eduardocasino/k-1013-floppy-disk-controller-replica/README.md

# K-1013 Floppy Disk Controller replica

## Introduction

Welcome to my K-1013 Rev. D Floppy Disk Controller replica repository.

This aims to be a faithful replica of the K-1013 Floppy Disk Controller, an extension board for the KIM-1 designed by MTU in the late 70's/early 80's for interfacing with [Shugart Associates](https://en.wikipedia.org/wiki/Shugart_Associates) compatible 8'' and 5.25'' FDDs.

### Status

Schematic is completed and checked against the real board.

Routing is completed, still in revision.

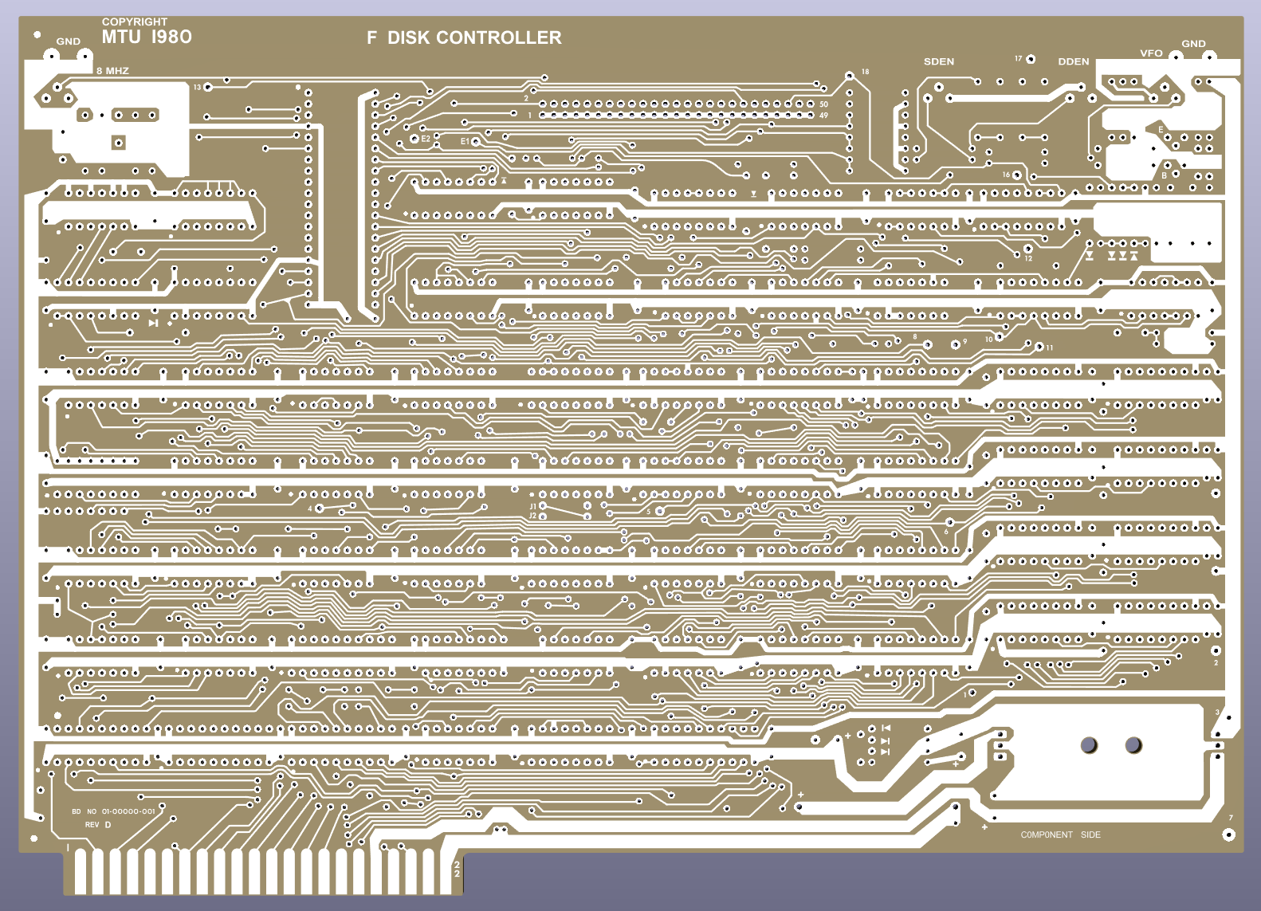
[picture p1: images/k-1013-floppy-controller-replica-front.png]
front

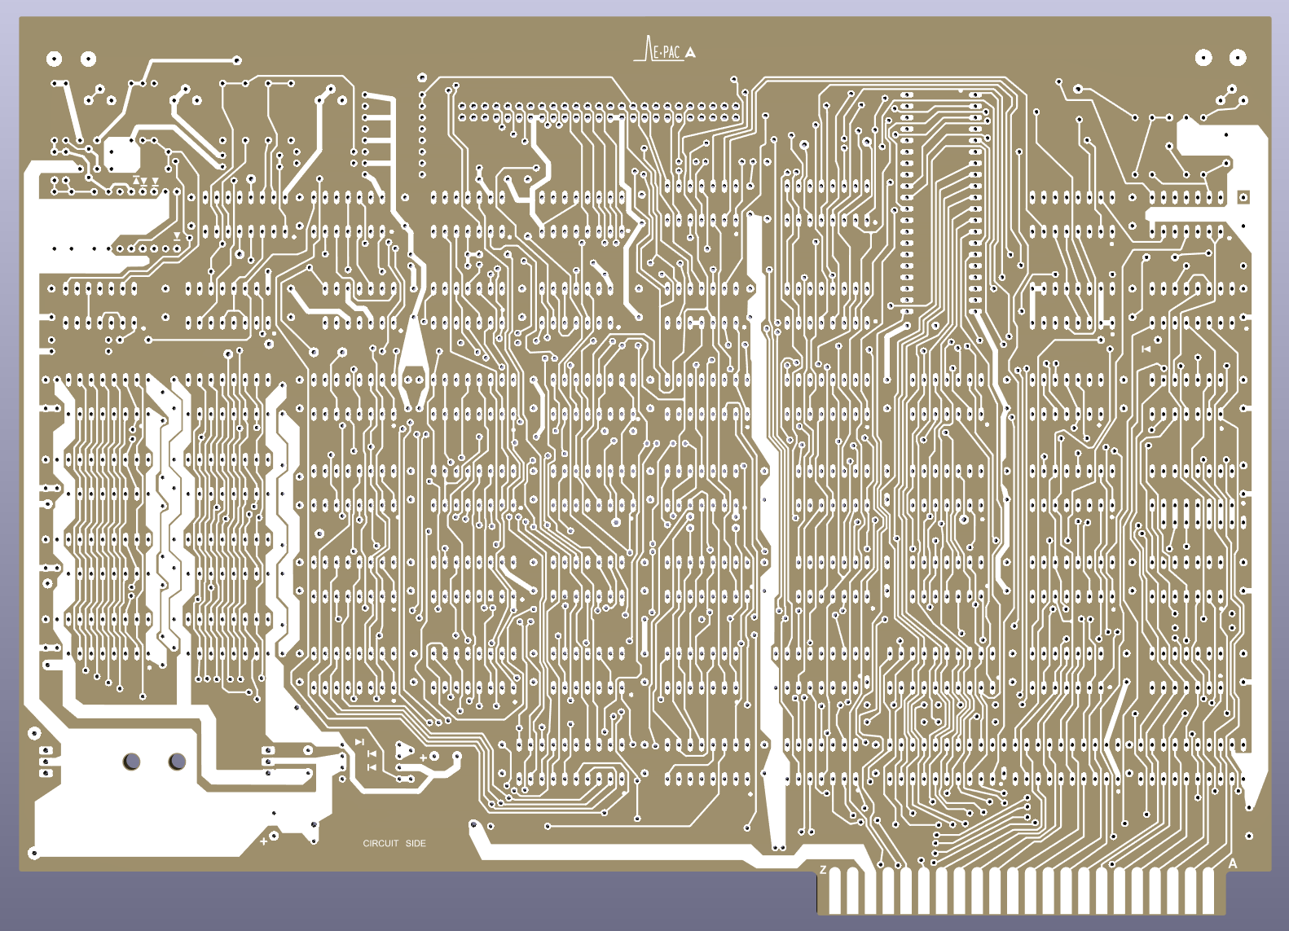
[picture p2: images/k-1013-floppy-controller-replica-back.png]
back

completed

**WARNING: This design is a work-in-progress has not been tested yet. Use at your own risk!**

## Building

TODO

## Licensing

This is a personal project that I am sharing in case it is of interest to any retrocomputing enthusiast and all the information in this repository is provided "as is", without warranty of any kind. I am not liable for any damages that may occur, whether it be to individuals, objects, KIM-1 computers, kittens or any other pets. **It should also be noted that everything in this repository is a work in progress and may contain errors. Therefore, anyone who chooses to use it does so at their own risk**.



This work is licensed under a [Creative Commons Attribution-NonCommercial 4.0 International License](http://creativecommons.org/licenses/by-nc/4.0/).

See the LICENSE.md file for details.

## Acknowledgements

* Dave Plummer, of [Dave's Garage](https://www.youtube.com/@DavesGarage) fame, for documentation and pictures of his card. I'm building this replica out of pure envy of his system!
* [David Williams](https://www.trailingedge.com/) for taking the time to disassemble his MTU-130 and send me hi-res pictures of his board.
* [Hans Otten](http://retro.hansotten.nl). Tons of documentation on his retro computing site.
