eduardocasino/k-1013-floppy-disk-controller-replica/3dmodels/3386P.STEP

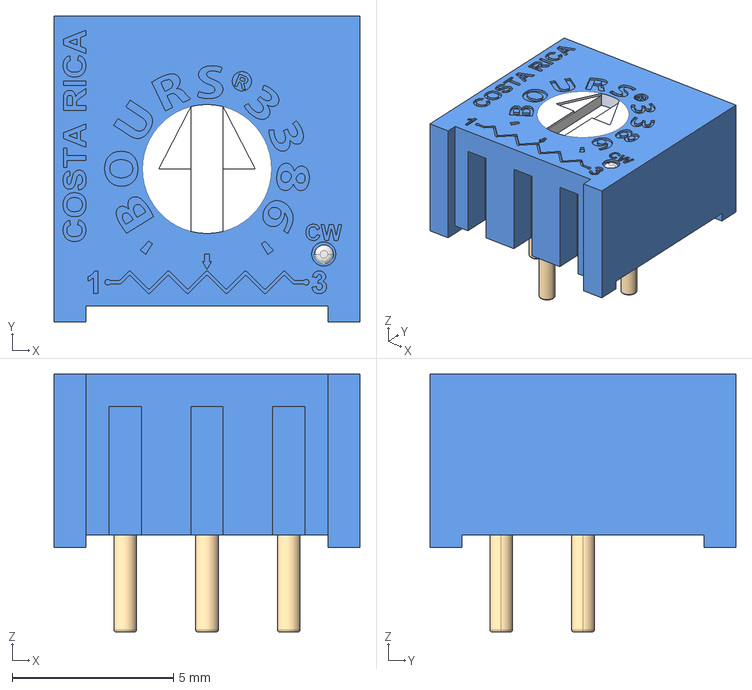
[picture p3: CAD file, 2024-11-11]
3dmodels/3386P.STEP
9.50 x 9.50 x 8.00 mm
