eduardocasino/k-1013-floppy-disk-controller-replica/3dmodels/a_16-lc-tt.stp

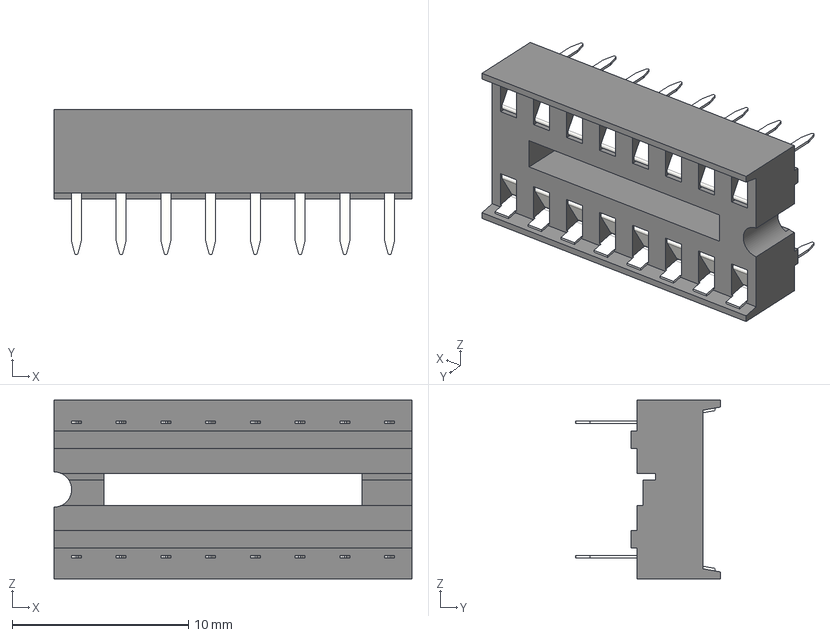
[picture p4: CAD file, 2024-11-11]
3dmodels/a_16-lc-tt.stp
20.3 x 8.25 x 10.2 mm
