eduardocasino/k-1013-floppy-disk-controller-replica/3dmodels/resistor_array_8.step

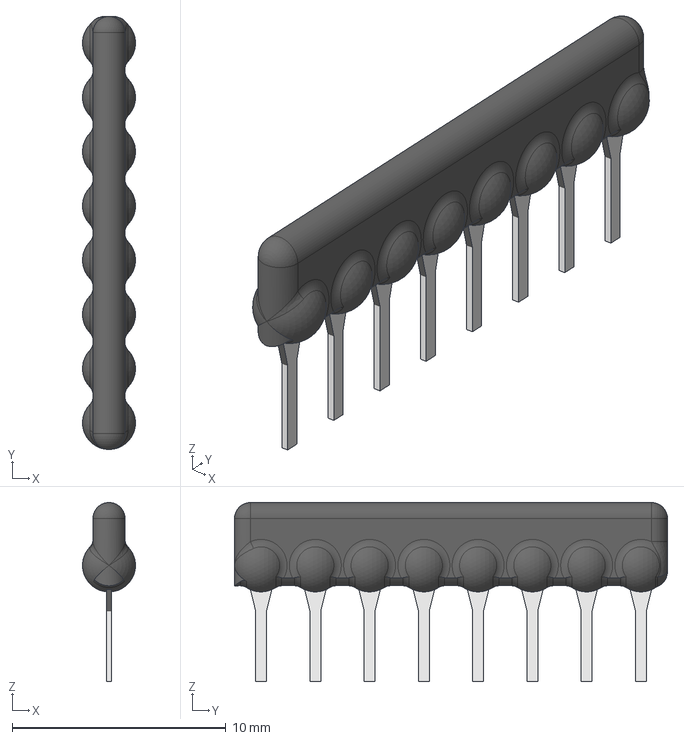
[picture p6: CAD file, 2024-09-01]
3dmodels/resistor_array_8.step
2.48 x 20.3 x 8.38 mm
