eduardocasino/k-1013-floppy-disk-controller-replica/3dmodels/DIP-20 W7.62mm IC with Socket.stp

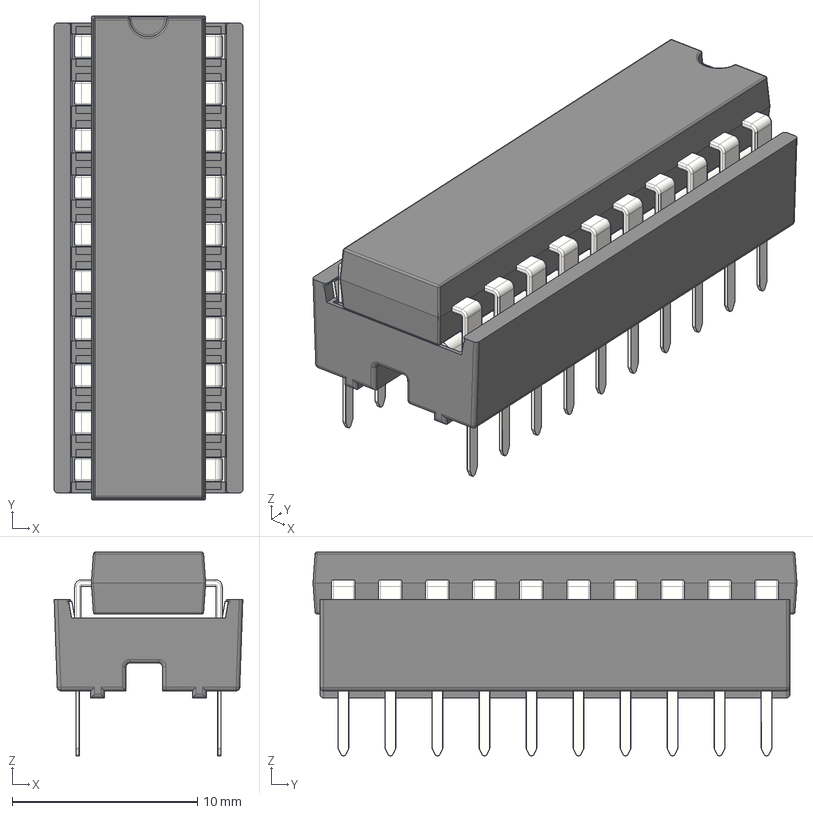
[picture p7: CAD file, 2024-09-01]
3dmodels/DIP-20 W7.62mm IC with Socket.stp
10.2 x 26.1 x 11.0 mm
Stamped Dual Wipe Contact for DIP Sockets x 20
Body DIP-20 P7.62mm Socket
IC Beinchen x 20
DIP-20 W7.62
