eduardocasino/k-1013-floppy-disk-controller-replica/3dmodels/res-1_4w-330R-12_7mm.step

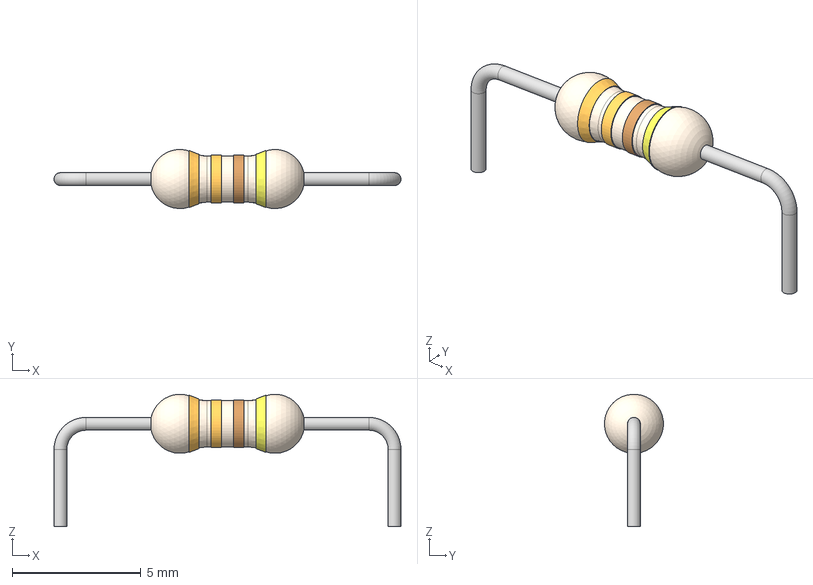
[picture p8: CAD file, 2024-09-01]
3dmodels/res-1_4w-330R-12_7mm.step
13.5 x 2.29 x 5.14 mm
Resistor-body
Ring-1
Ring-2
Ring-3
Ring-4
pins
