eduardocasino/k-1013-floppy-disk-controller-replica/3dmodels/DIP-14 W7.62mm IC with Socket.stp

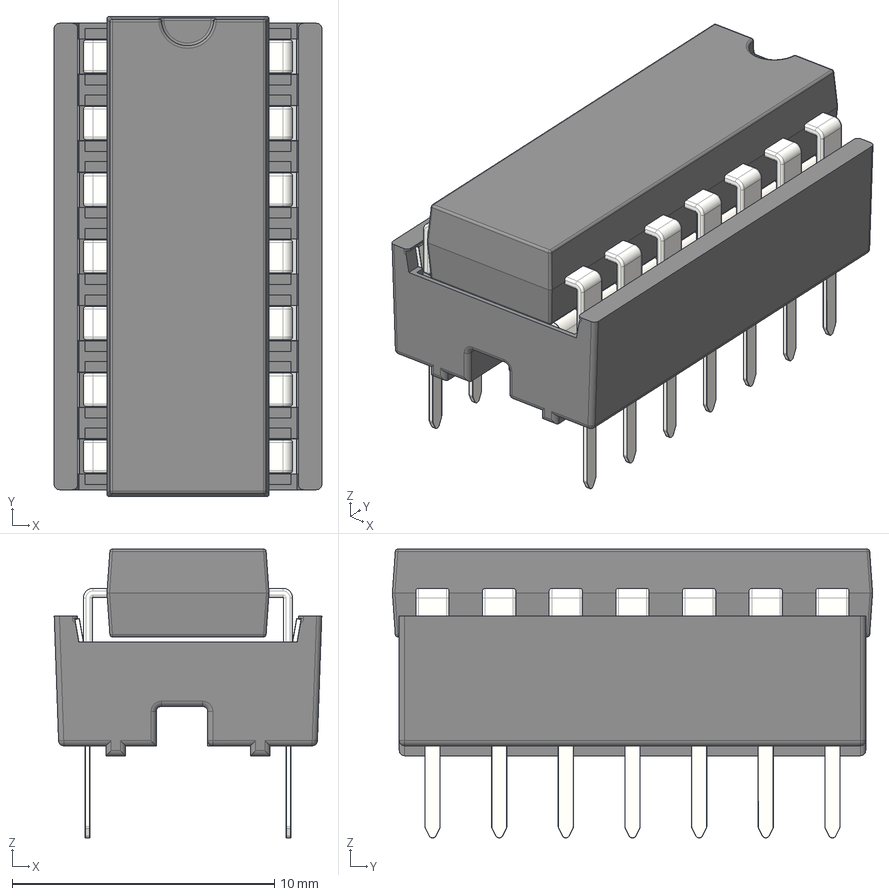
[picture p9: CAD file, 2024-09-01]
3dmodels/DIP-14 W7.62mm IC with Socket.stp
10.2 x 18.3 x 11.0 mm
Stamped Dual Wipe Contact for DIP Sockets x 14
Body DIP-14 P7.62mm Socket
IC Beinchen x 14
DIP-14 W7.62
