eduardocasino/k-1013-floppy-disk-controller-replica/3dmodels/DIP-16 W7.62mm IC with Socket.stp

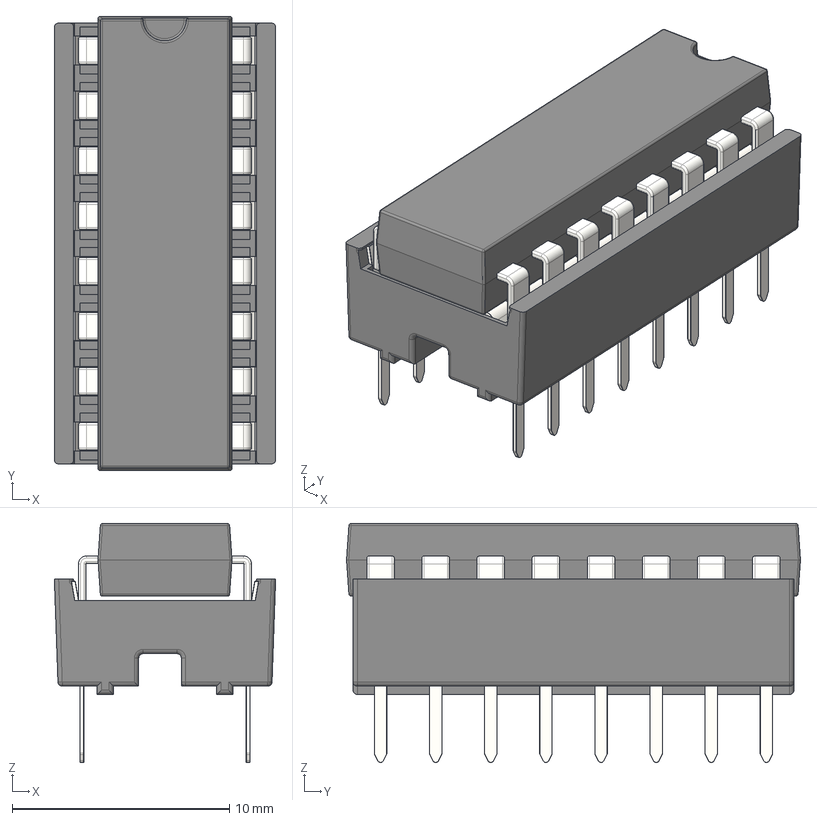
[picture p10: CAD file, 2024-09-01]
3dmodels/DIP-16 W7.62mm IC with Socket.stp
10.2 x 20.9 x 11.0 mm
Stamped Dual Wipe Contact for DIP Sockets x 16
Body DIP-16 P7.62mm Socket
IC Beinchen x 16
DIP-16 W7.62
