eduardocasino/k-1013-floppy-disk-controller-replica/3dmodels/DIP-40 W15.24mm IC with Socket.stp

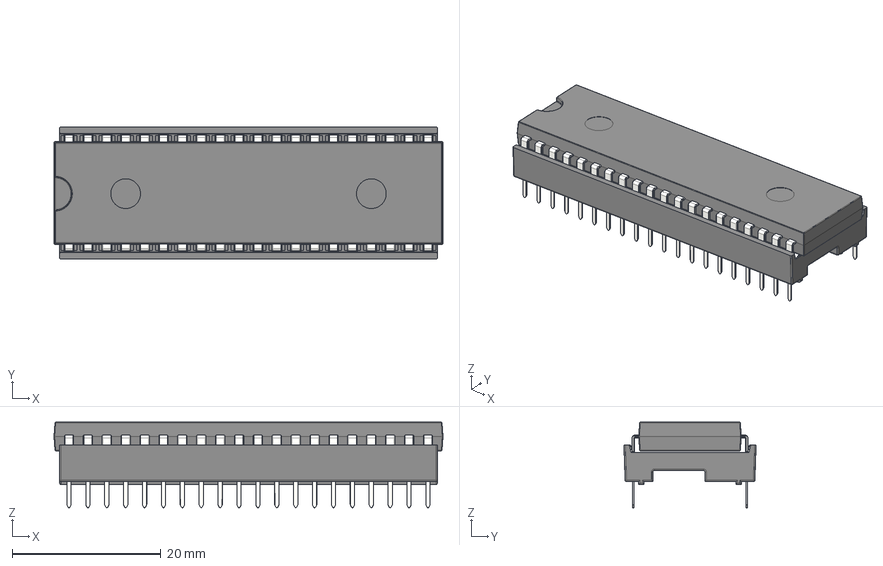
[picture p11: CAD file, 2024-09-01]
3dmodels/DIP-40 W15.24mm IC with Socket.stp
52.3 x 17.8 x 11.5 mm
Stamped Dual Wipe Contact for DIP Sockets x 40
Body DIP-48 Socket
IC Beinchen x 40
DIP-40 W15.24
