eduardocasino/k-1013-floppy-disk-controller-replica/(list of files, cad)

Other CAD files:
3dmodels/res-1_4w-1K-12_7mm.step
3dmodels/res-1_4w-51K-12_7mm.step
3dmodels/res-1_4w-3K-12_7mm.step
3dmodels/res-1_4w-4K7-12_7mm.step
3dmodels/res-1_4w-220R-12_7mm.step
3dmodels/res-1_4w-3K3-12_7mm.step
3dmodels/res-1_4w-470R-12_7mm.step
3dmodels/res-1_4w-270R-12_7mm.step
3dmodels/res-1_4w-10K-12_7mm.step
3dmodels/res-1_4w-1K5-12_7mm.step
3dmodels/res-1_4w-820K-12_7mm.step
3dmodels/res-1_4w-2K2-12_7mm.step
3dmodels/507222B00000G.stp
