eduardocasino/k-1013-floppy-disk-controller-replica/docs/k-1013-floppy-controller-replica.pdf

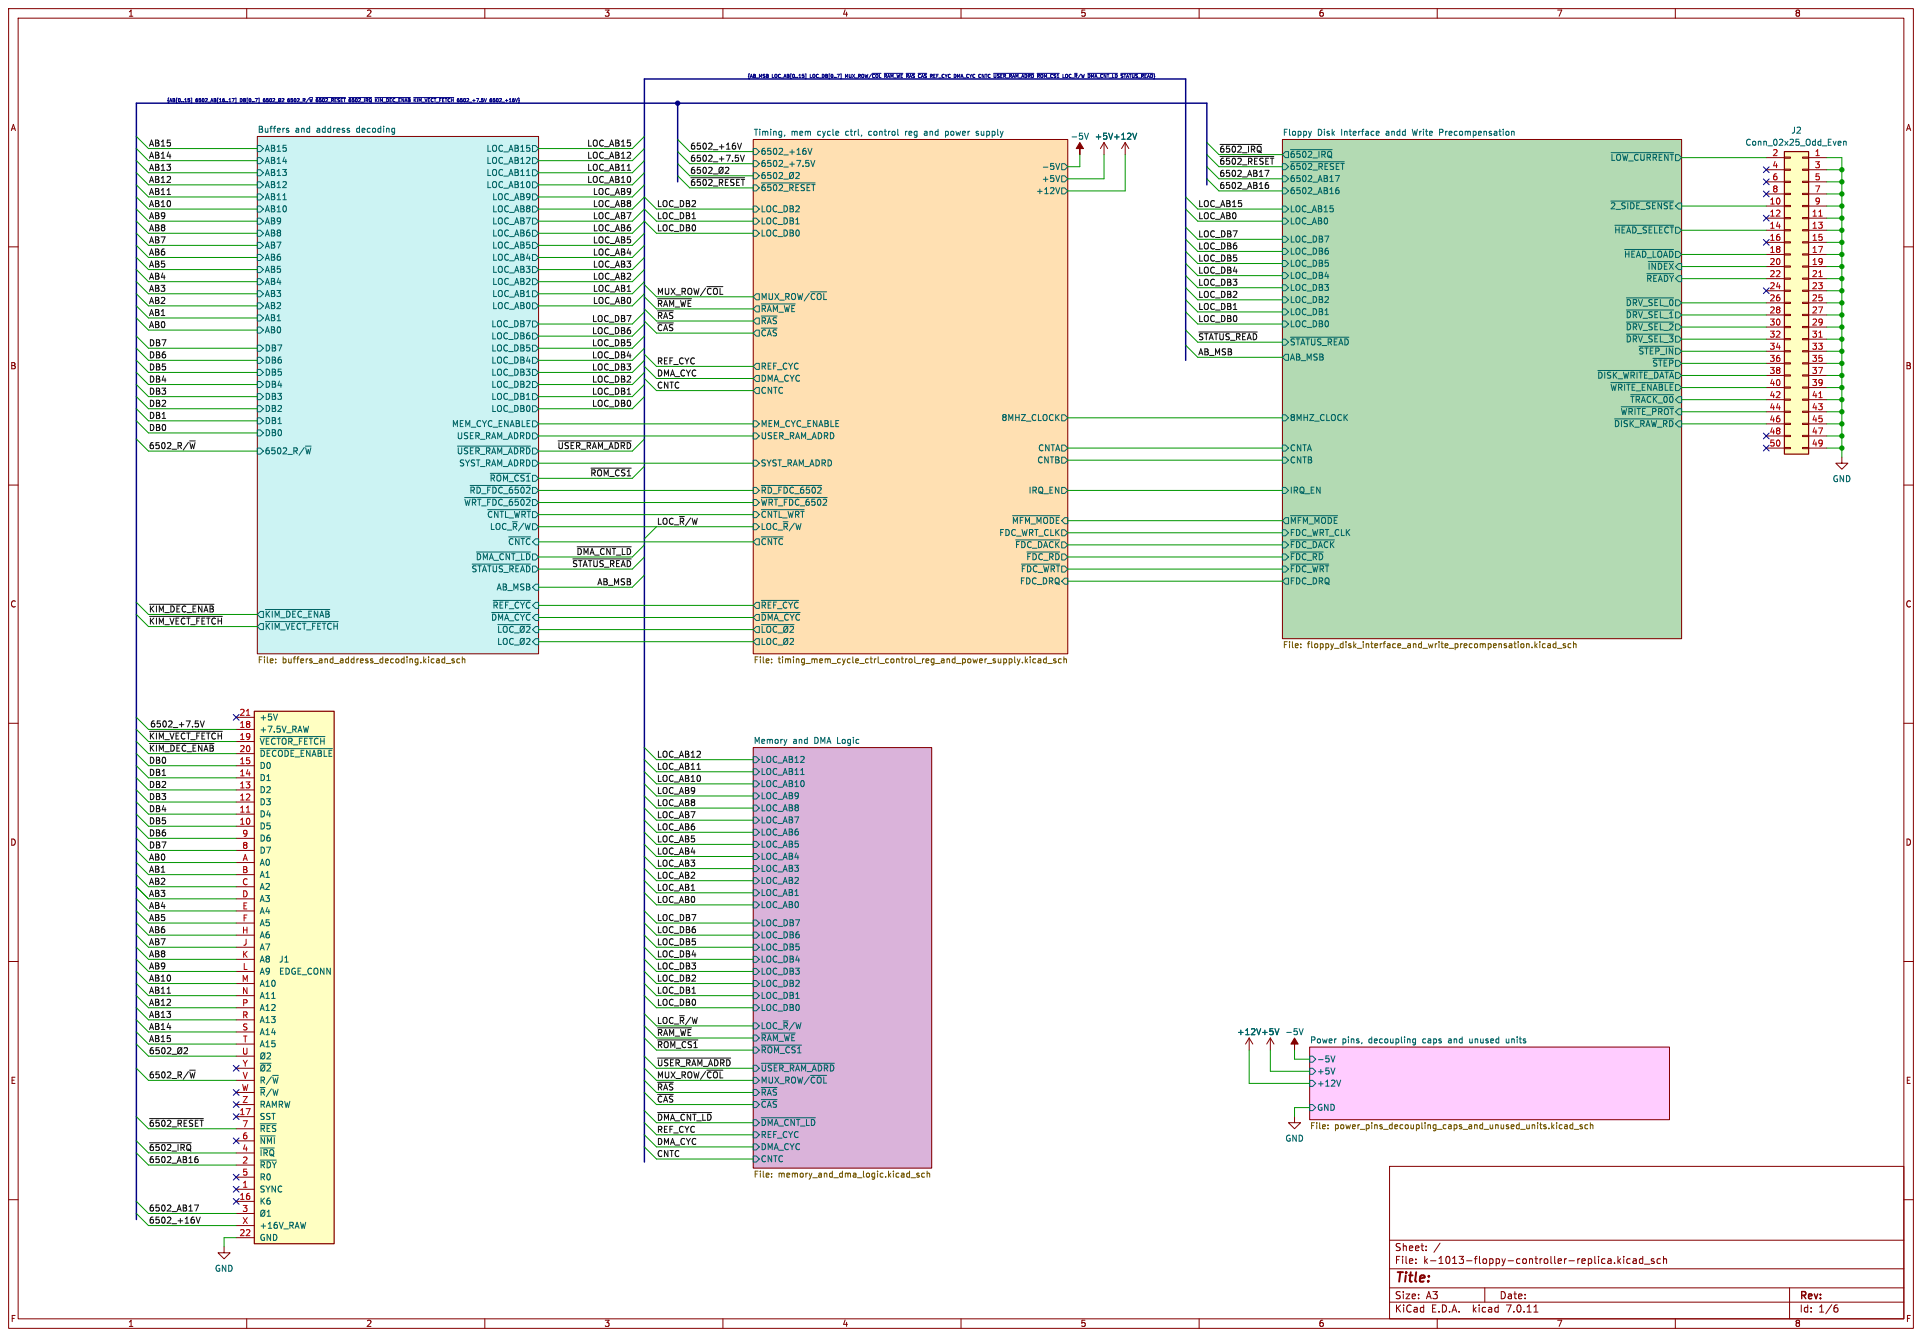
[picture p12: page 1]

AB15 AB14 AB13 AB11 AB12 AB10 AB9 AB8 AB7 AB6 AB5 AB4 AB3 AB2 AB1 AB0 Buffers and address decoding File: buffers_and_address_decoding.kicad_sch

SYST_RAM_ADRD
Memory and DMA Logic File: memory_and_dma_logic.kicad_sch
LOC_AB9 MUX_ROW/~{COL} LOC_AB12

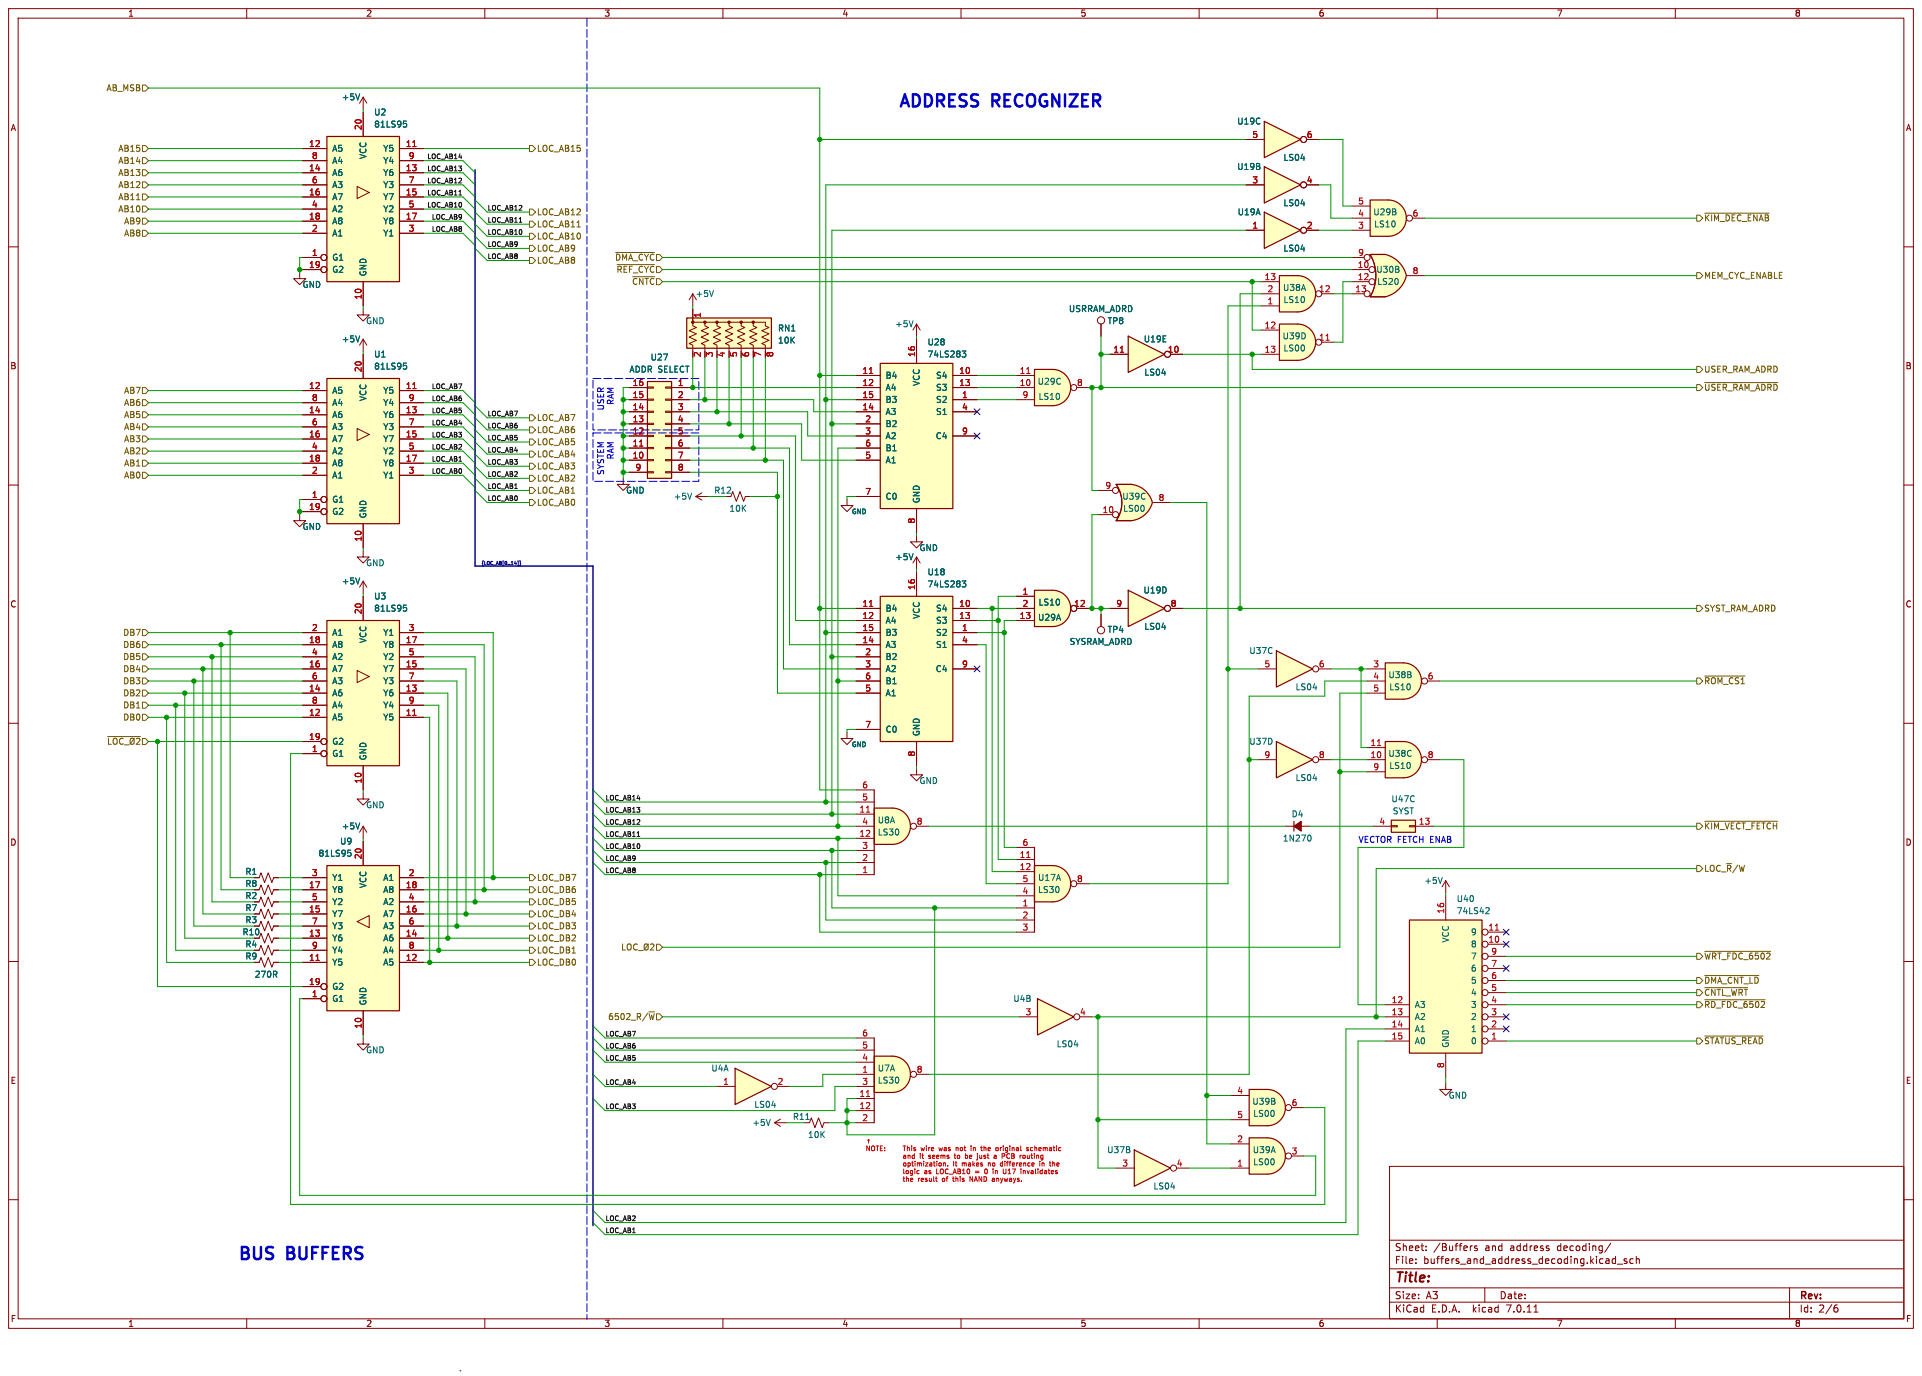
[picture p13: page 2]

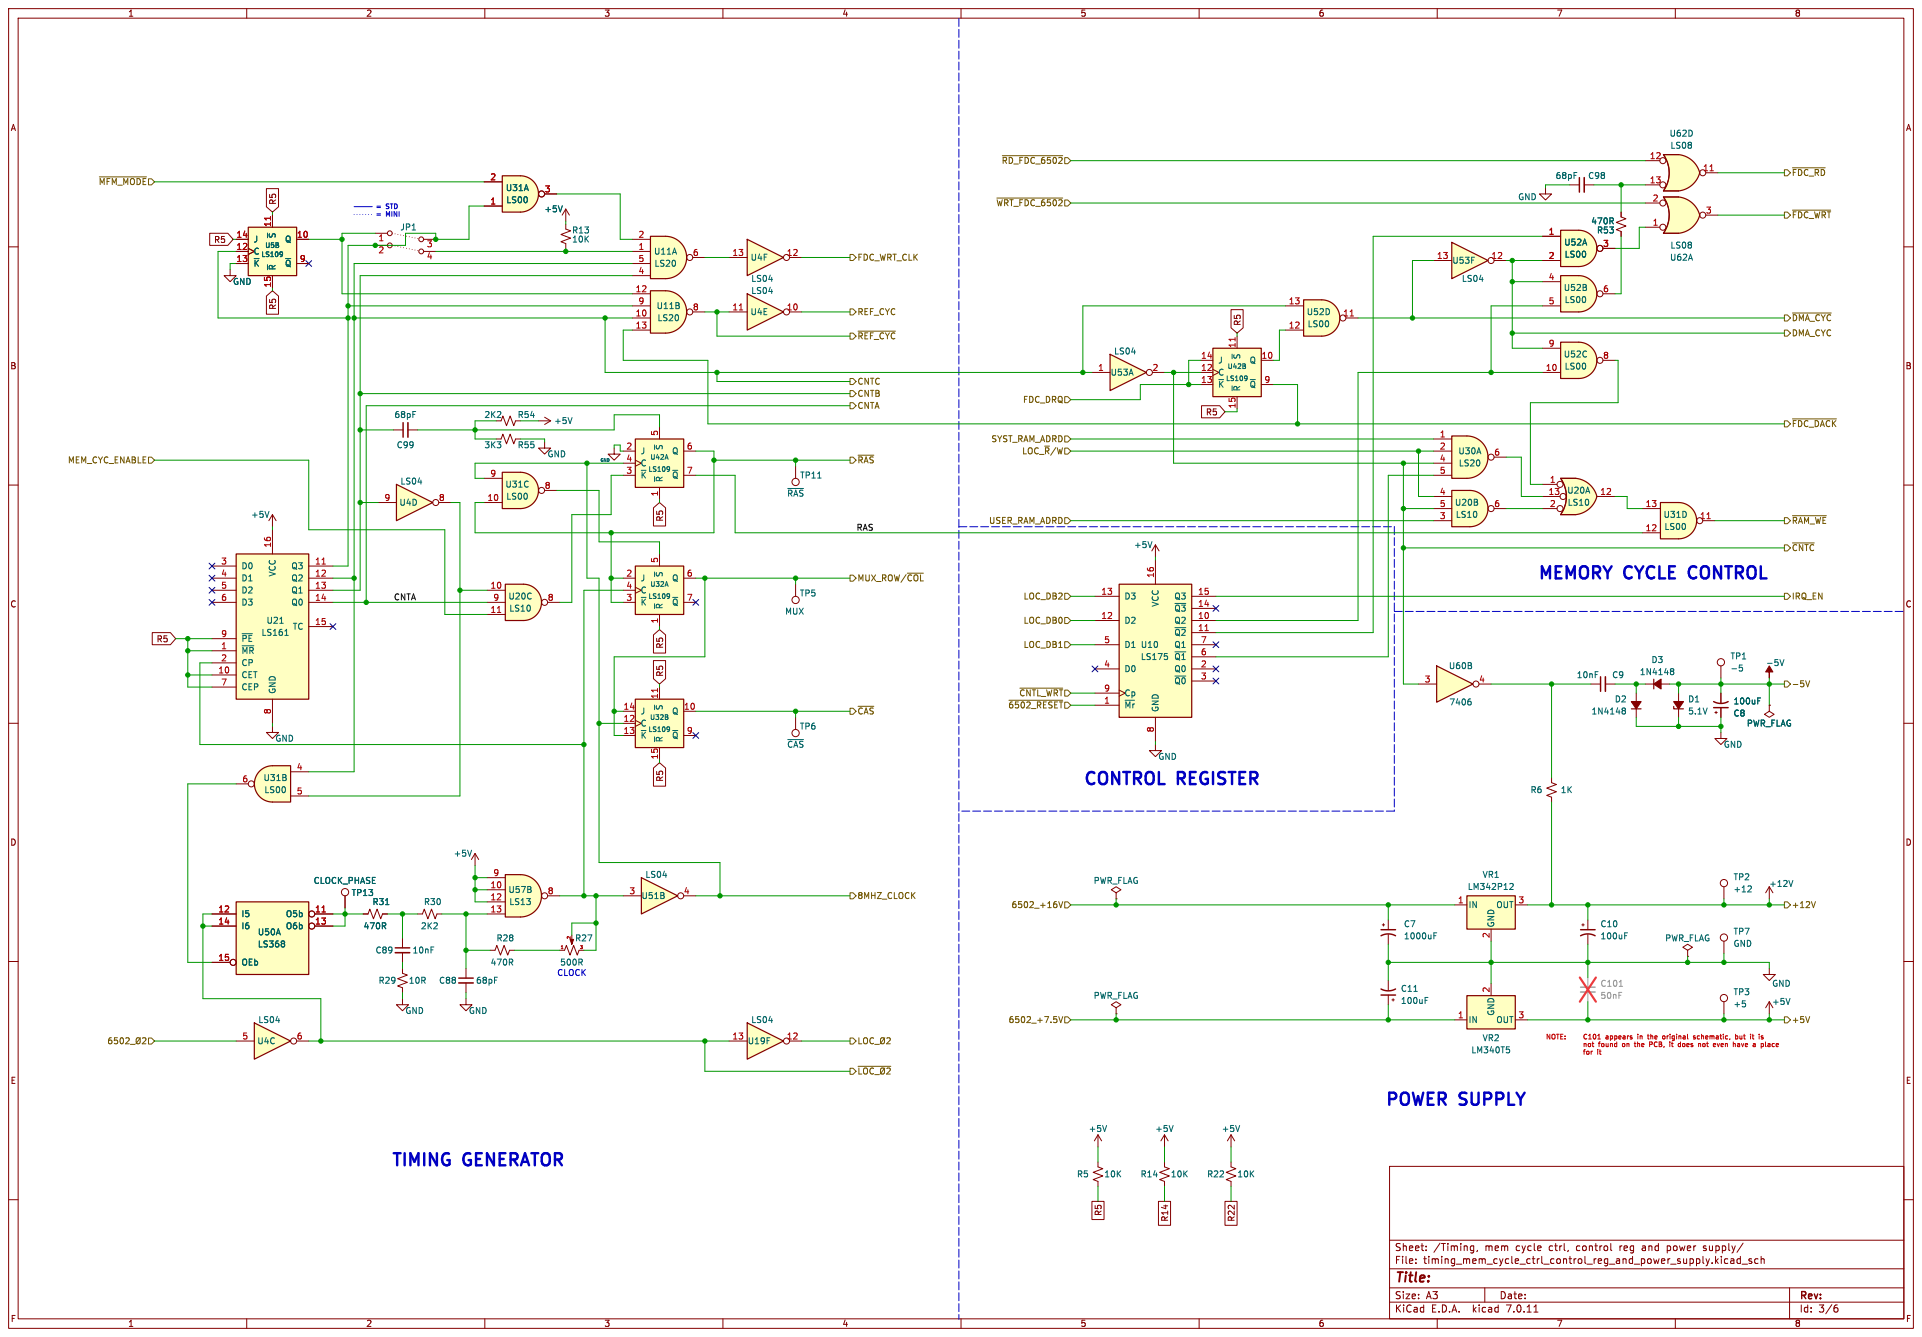
[picture p14: page 3]

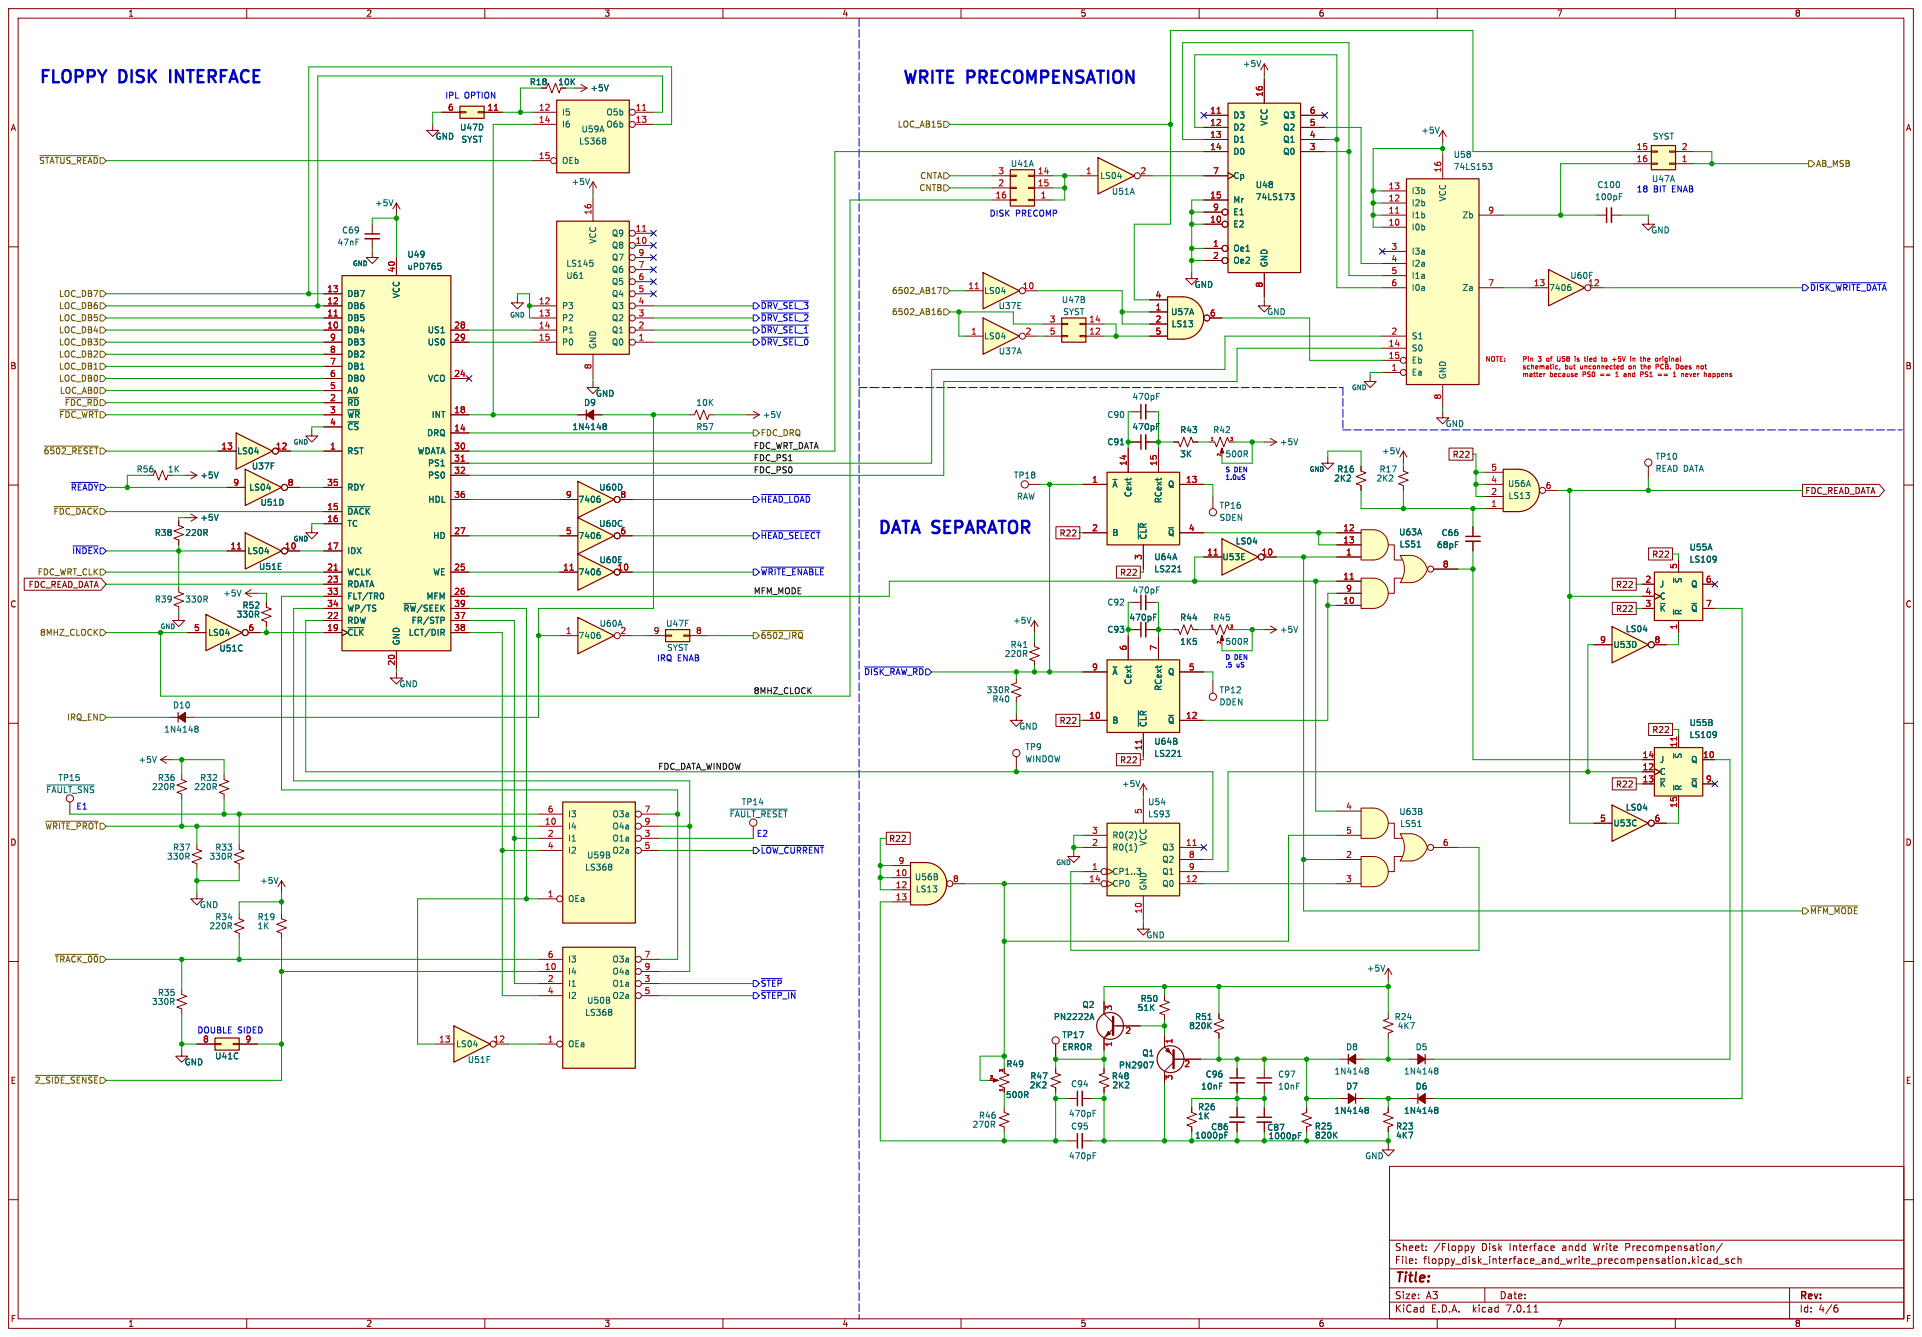
[picture p15: page 4]

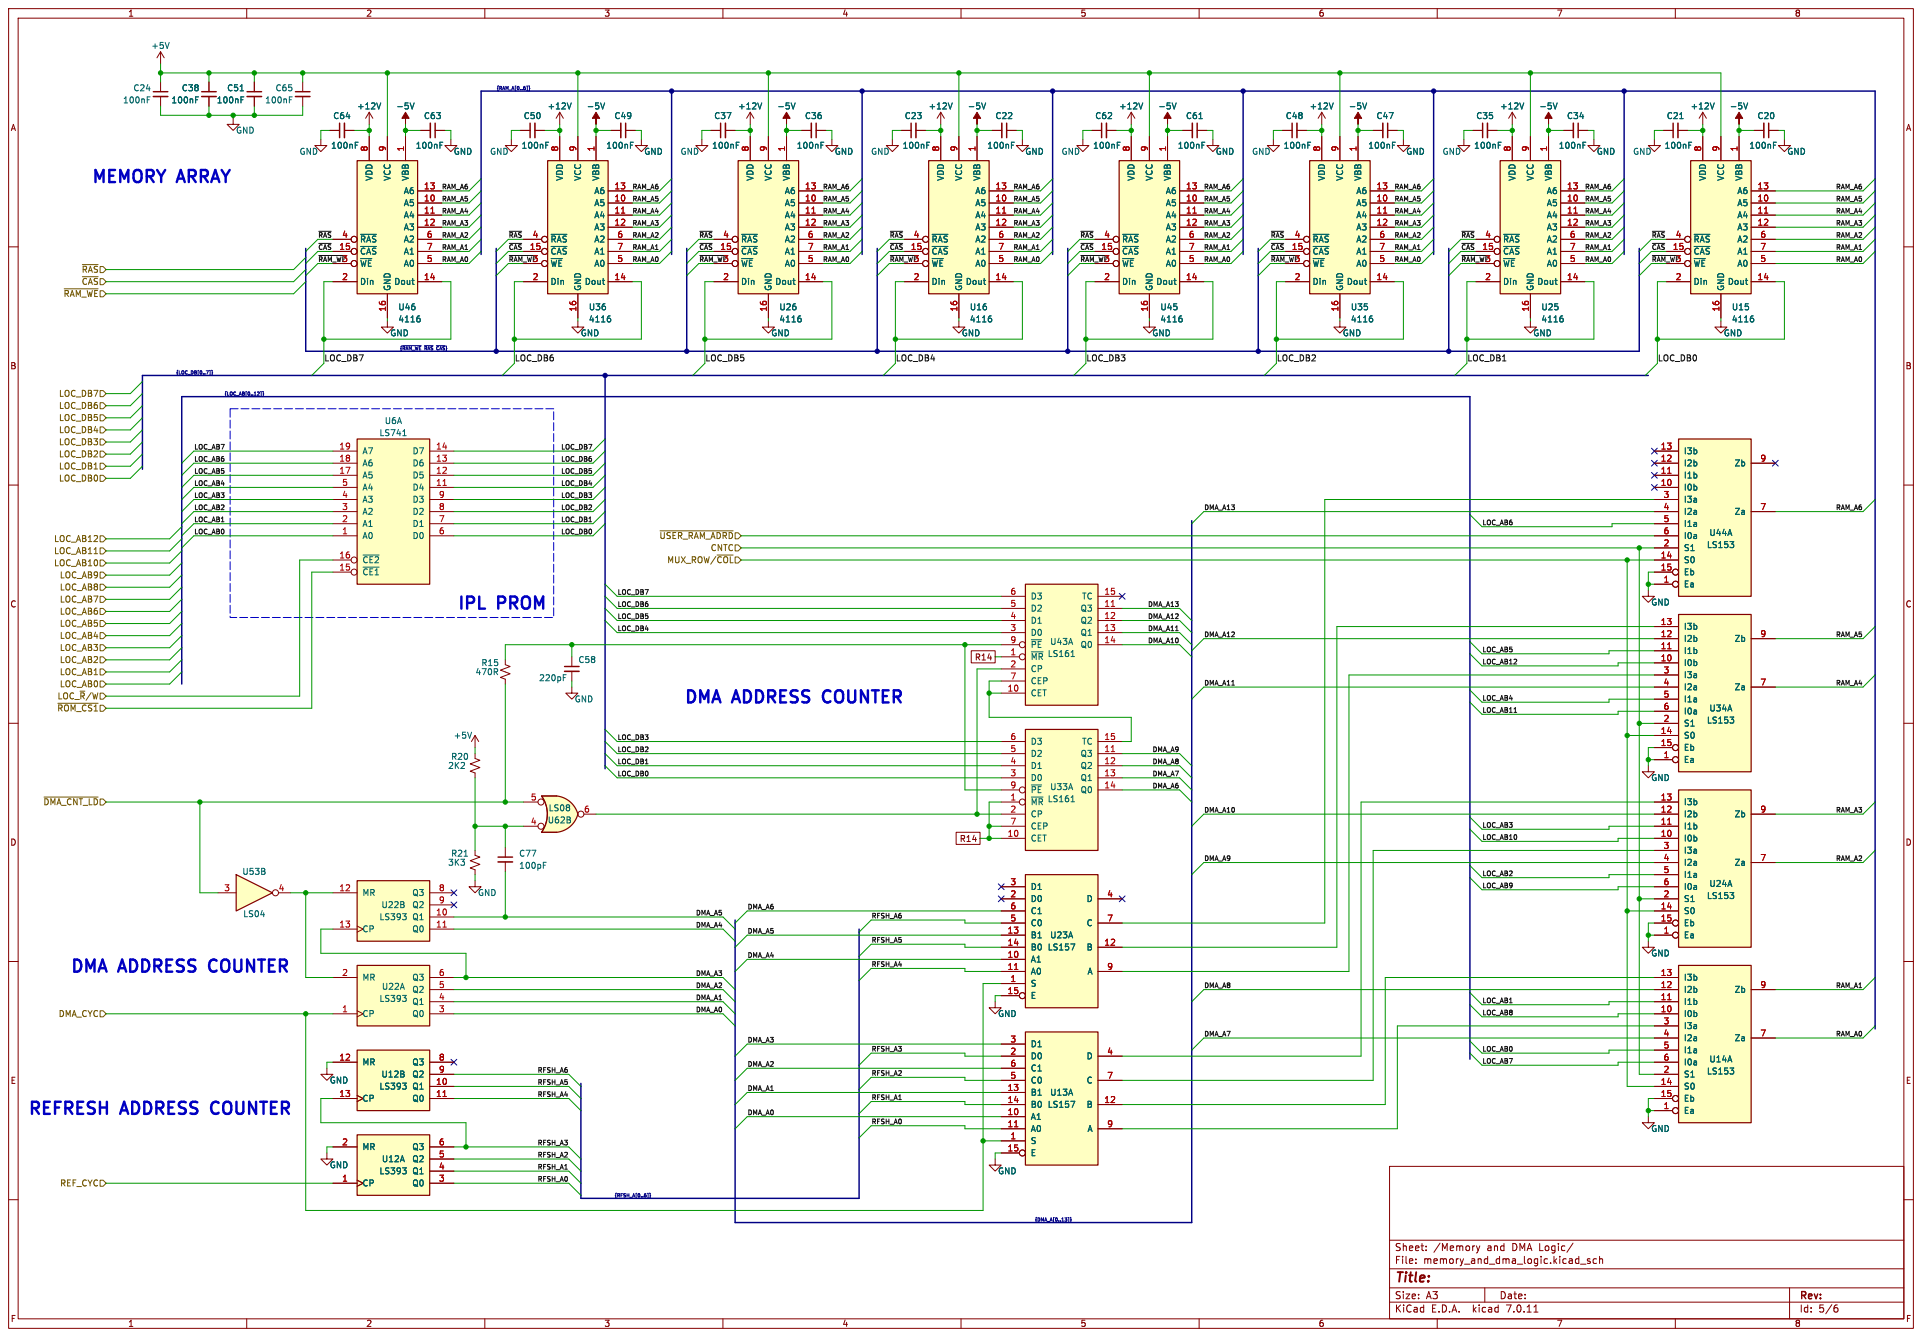
[picture p16: page 5]

9 A5 10 A4 11 A3 12 A6 13 Dout 14 ~{CAS} 15 Din 2 ~{WE} 3 ~{RAS} 4 A0 5 A2 6 A1 7 +12V GND

9 A5 10 A4 11 A3 12 A6 13 Dout 14 ~{CAS} 15 Din 2 ~{WE} 3 ~{RAS} 4 A0 5 A2 6 A1 7 C48

9 A5 10 A4 11 A3 12 A6 13 Dout 14 ~{CAS} 15 Din 2 ~{WE} 3 ~{RAS} 4 A0 5 A2 6 A1 7 U46

9 A5 10 A4 11 A3 12 A6 13 Dout 14 ~{CAS} 15 Din 2 ~{WE} 3 ~{RAS} 4 A0 5 A2 6 A1 7 GND

9 A5 10 A4 11 A3 12 A6 13 Dout 14 ~{CAS} 15 Din 2 ~{WE} 3 ~{RAS} 4 A0 5 A2 6 A1 7 GND GND GND
4116 GND

9 A5 10 A4 11 A3 12 A6 13 Dout 14 ~{CAS} 15 Din 2 ~{WE} 3 ~{RAS} 4 A0 5 A2 6 A1 7 U36

9 A5 10 A4 11 A3 12 A6 13 Dout 14 ~{CAS} 15 Din 2 ~{WE} 3 ~{RAS} 4 A0 5 A2 6 A1 7 U26

9 A5 10 A4 11 A3 12 A6 13 Dout 14 ~{CAS} 15 Din 2 ~{WE} 3 ~{RAS} 4 A0 5 A2 6 A1 7 U16

9 A5 10 A4 11 A3 12 A6 13 Dout 14 ~{CAS} 15 Din 2 ~{WE} 3 ~{RAS} 4 A0 5 A2 6 A1 7 U45

9 A5 10 A4 11 A3 12 A6 13 Dout 14 ~{CAS} 15 Din 2 ~{WE} 3 ~{RAS} 4 A0 5 A2 6 A1 7 U35

9 A5 10 A4 11 A3 12 A6 13 Dout 14 ~{CAS} 15 Din 2 ~{WE} 3 ~{RAS} 4 A0 5 A2 6 A1 7 U25

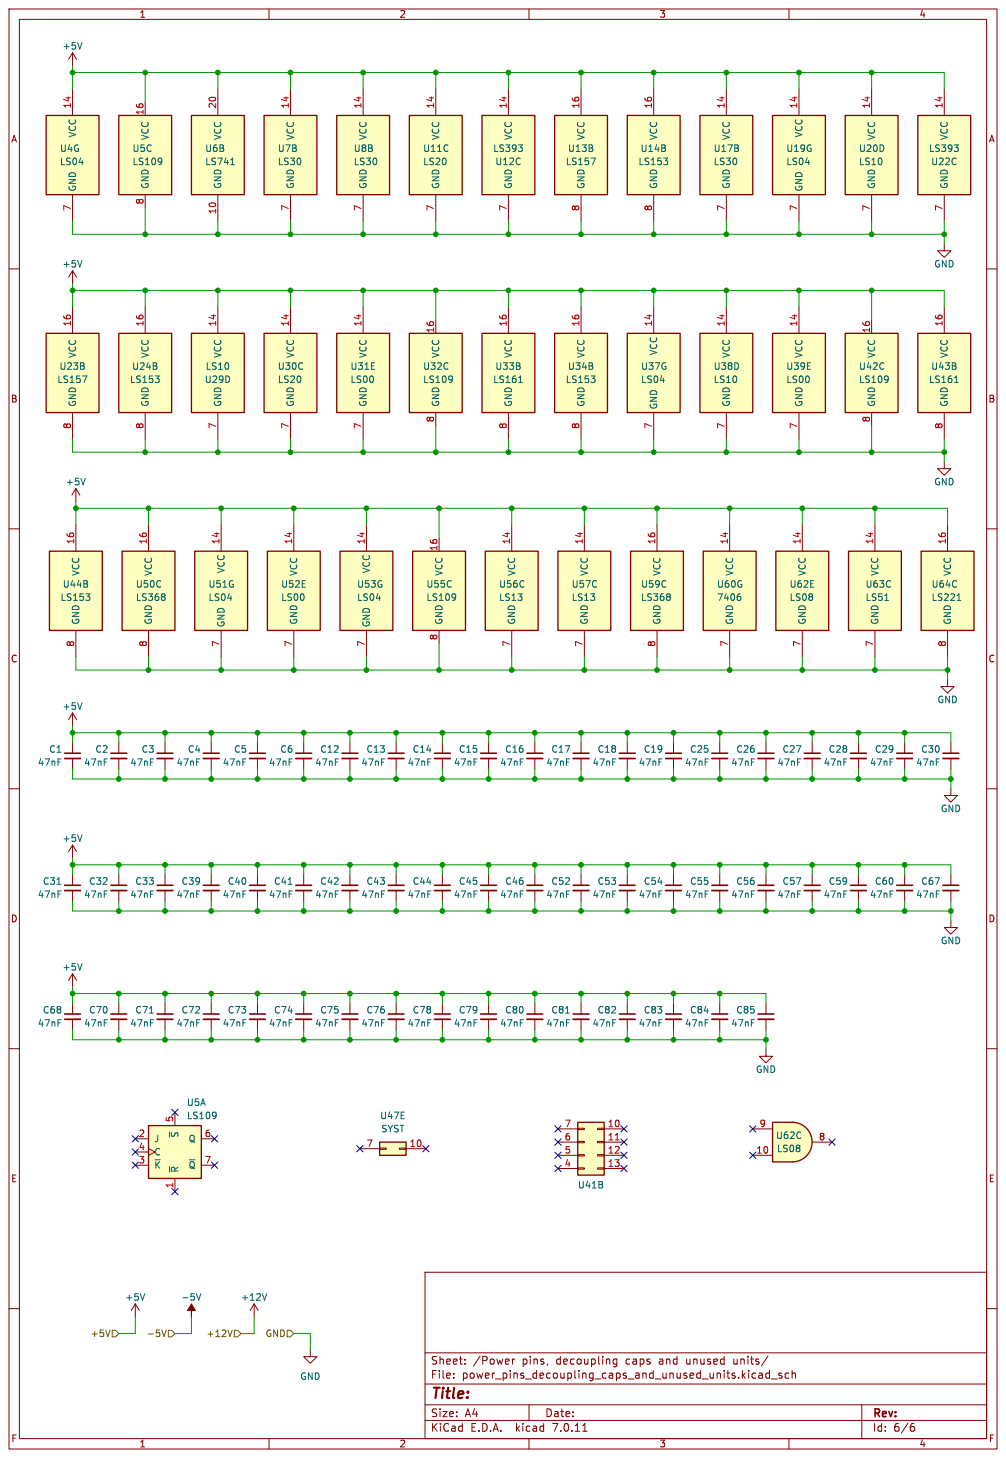
[picture p17: page 6]
