eduardocasino/k-1013-floppy-disk-controller-replica/(commit log)

2023-12-08 First version of the schematic completed
    [buffers_and_address_decoding.kicad_sch, floppy_disk_interface_and_write_precompensation.kicad_sch, k-1013-floppy-controller-replica.kicad_sch, memory_and_dma_logic.kicad_sch, power_pins_decoupling_caps_and_unused_units.kicad_sch, timing_mem_cycle_ctrl_control_reg_and_power_supply.kicad_sch]
2023-12-24 Schematic corrections
    [buffers_and_address_decoding.kicad_sch, floppy_disk_interface_and_write_precompensation.kicad_sch, k-1013-floppy-controller-replica.kicad_sch, memory_and_dma_logic.kicad_sch, power_pins_decoupling_caps_and_unused_units.kicad_sch, timing_mem_cycle_ctrl_control_reg_and_power_supply.kicad_sch]
2024-08-16 Update progress
    [3362P-1-102LF.STEP, buffers_and_address_decoding.kicad_sch, floppy_disk_interface_and_write_precompensation.kicad_sch, k-1013-floppy-controller-replica.kicad_sch, memory_and_dma_logic.kicad_sch, power_pins_decoupling_caps_and_unused_units.kicad_sch, timing_mem_cycle_ctrl_control_reg_and_power_supply.kicad_sch]
2024-08-16 Add schematic in pdf format
2024-08-20 Routing of the bottom layer completed
    [buffers_and_address_decoding.kicad_sch, floppy_disk_interface_and_write_precompensation.kicad_sch, memory_and_dma_logic.kicad_sch, power_pins_decoupling_caps_and_unused_units.kicad_sch, timing_mem_cycle_ctrl_control_reg_and_power_supply.kicad_sch]
2024-09-01 Completed first version of board routing
    [507222B00000G.stp, DIP-14 W7.62mm IC with Socket.stp, DIP-16 W7.62mm IC with Socket.stp, DIP-20 W7.62mm IC with Socket.stp, DIP-40 W15.24mm IC with Socket.stp, SW-NDS-08V.stp, buffers_and_address_decoding.kicad_sch, floppy_disk_interface_and_write_precompensation.kicad_sch]
2024-09-01 Update schematic PDF
2024-09-28 Retrace a couple of traces that caused problems with gerber generation
2024-10-05 Add mask layers to mask out the entire board
2024-11-11 Cosmetic changes
    [3362P-1-102LF.STEP, 3386P.STEP, SW-NDS-08V.stp, a_16-lc-tt.stp, buffers_and_address_decoding.kicad_sch, floppy_disk_interface_and_write_precompensation.kicad_sch, k-1013-floppy-controller-replica.kicad_sch, power_pins_decoupling_caps_and_unused_units.kicad_sch]
