eduardocasino/k-1013-floppy-disk-controller-replica/(notices)

Notices in the files:
README.md:
CC BY-NC 4.0
